Push3AX/USBKeylogger/images/case.jpg

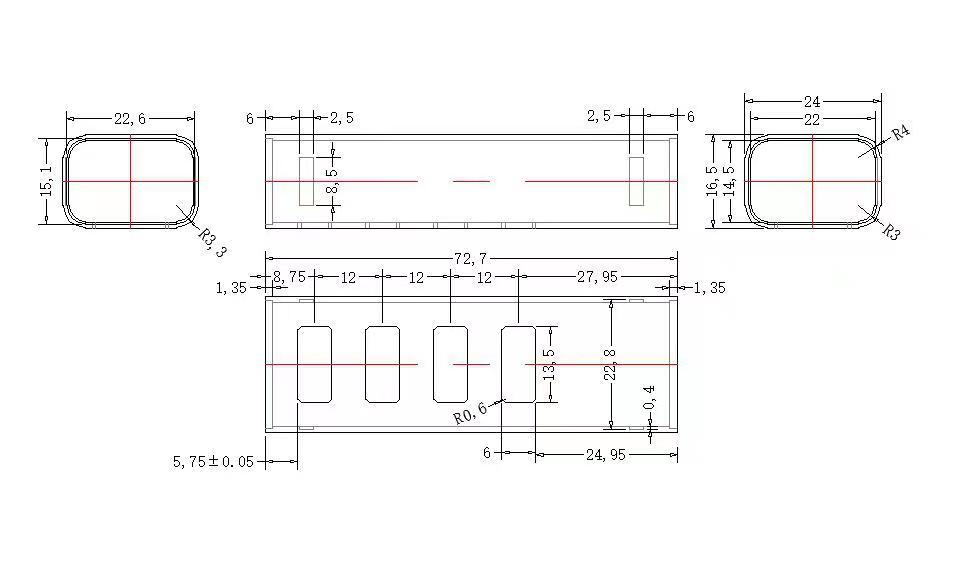
images/case.jpg
