Push3AX/USBKeylogger/images/web.jpg

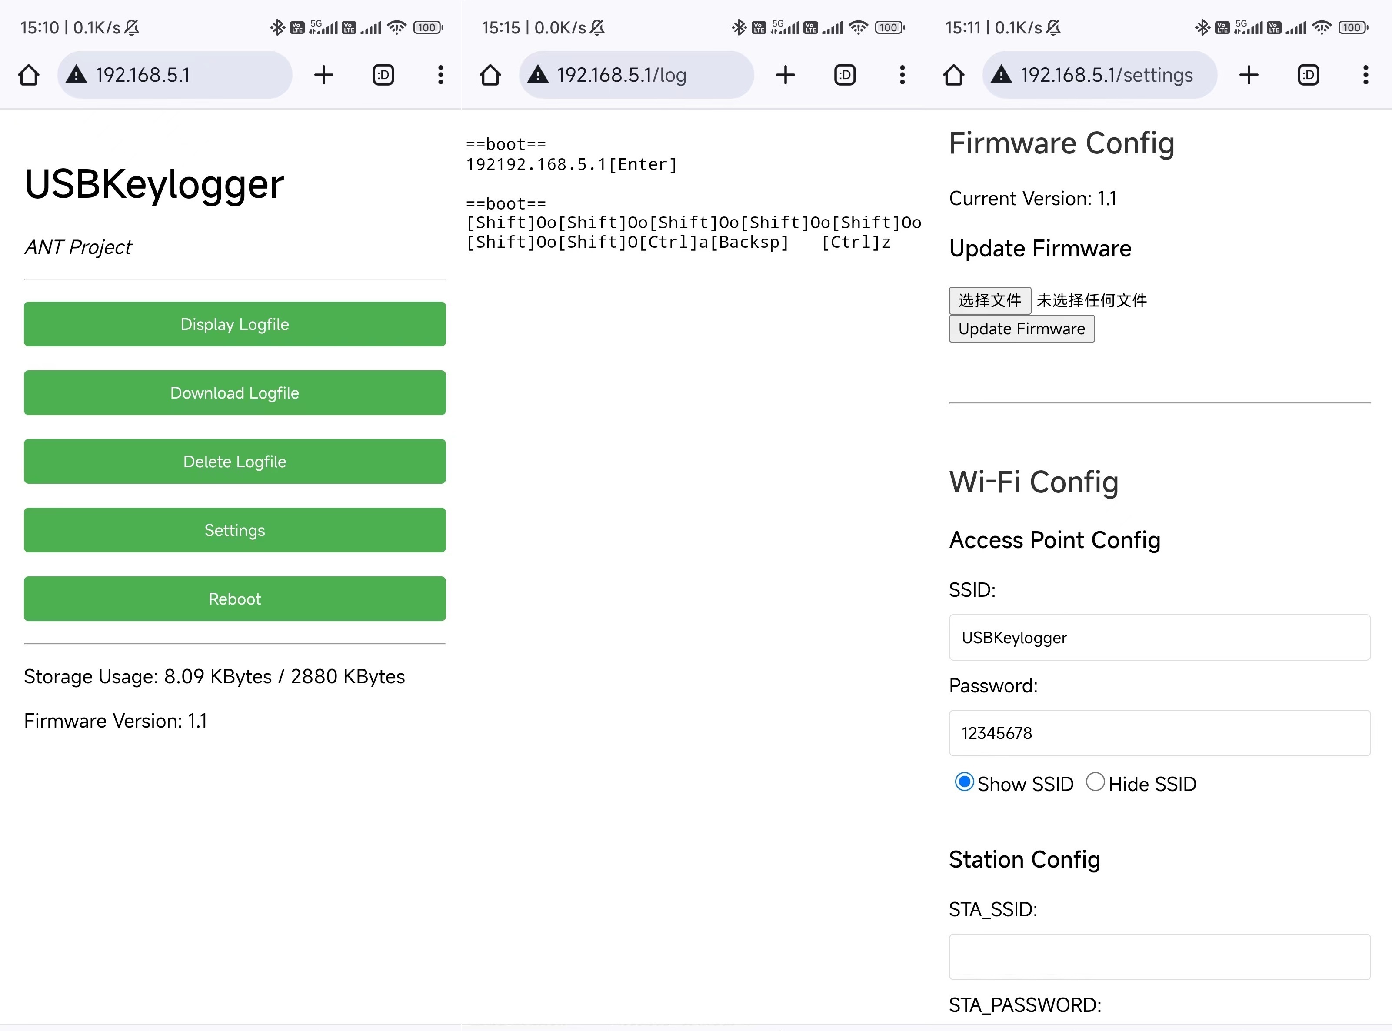
images/web.jpg
