Push3AX/USBKeylogger/Hardware/V2/BOM_USBKeylogger_v2.xlsx

No. | Quantity | Comment | Designator | Footprint | Value | Manufacturer Part | Manufacturer | Supplier Part | Supplier
1 | 8 | 10uF | C1,C3,C5,C9,C10,C11,C13,C15 | C0603 | 10uF | CL10A106MA8NRNC | SAMSUNG(三星) | C96446 | LCSC
2 | 9 | 100nF | C2,C4,C6,C8,C12,C14,C16,C18,C20 | C0603 | 100nF | CC0603KRX7R9BB104 | YAGEO(国巨) | C14663 | LCSC
3 | 3 | 10uF | C7,C17,C19 | CAP-SMD_L3.2-W1.6-RD-C7171 | 10uF | TAJA106K016RNJ | Kyocera AVX | C7171 | LCSC
4 | 1 | ASMD1206-200 | F1 | F1206 |  | ASMD1206-200 | JDTfuse集电通 | C135342 | LCSC
5 | 1 | 2.54-1*4P反弯排针 | H1 | HDR-TH_4P-P2.54-H-M-W10.4 |  | 2.54-1*4P反弯排针 | BOOMELE(博穆精密) | C91552 | LCSC
6 | 1 | ESP-07S | MK1 | WIRELM-SMD_ESP-07S |  | ESP-07S | Ai-Thinker(安信可) | C82895 | LCSC
7 | 1 | SL2.1A | U1 | SOP-16_L10.0-W3.9-P1.27-LS6.0-BL |  | SL2.1A | CoreChips(和芯润德) | C192893 | LCSC
8 | 1 | AMS1117-3.3 | U2 | SOT-223-4_L6.5-W3.5-P2.30-LS7.0-BR |  | AMS1117-3.3 | UMW(友台半导体) | C347222 | LCSC
9 | 2 | CH9350L | U3,U4 | LQFP-48_L7.0-W7.0-P0.50-LS9.0-BL |  | CH9350L | WCH(南京沁恒) | C109472 | LCSC
10 | 4 | 916-351A1024Y10200 | USB1,USB2,USB3,USB4 | USB-A-TH_USB-M-8 |  | 916-351A1024Y10200 | 精拓金 | C39453 | LCSC
11 | 1 | 12MHz | X1 | CRYSTAL-SMD_4P-L2.5-W2.0-BL | 12MHz | TXM12M0004252LBCEO00T | TAE(雅晶鑫) | C284156 | LCSC
