Push3AX/USBKeylogger/Hardware/V2/PCB_USBKeylogger_v2.pdf

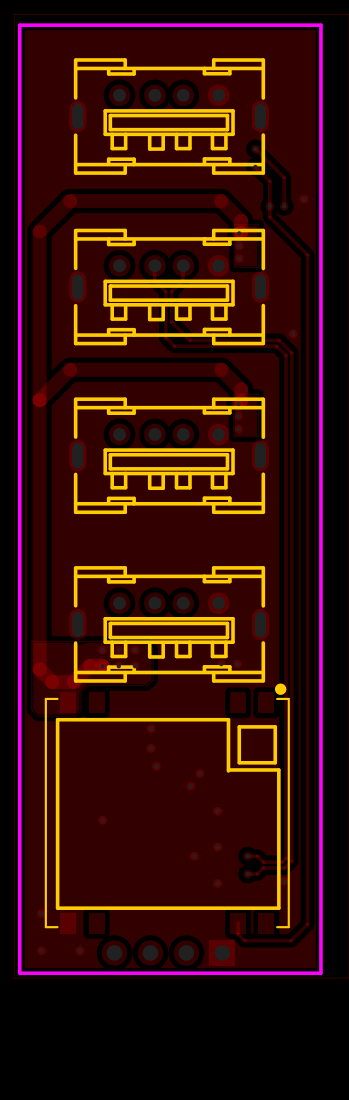
[picture p14: page 1]

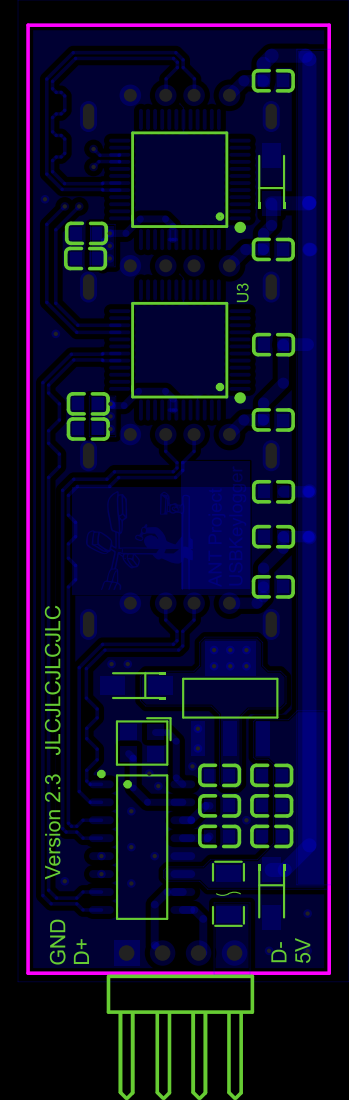
[picture p15: page 2]

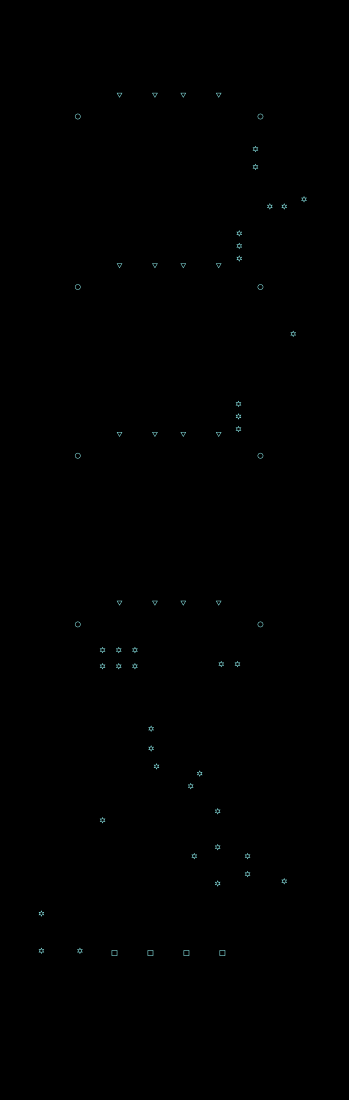
[picture p16: page 3]
