Push3AX/USBKeylogger/USBKeylogger.ino/USBKeylogger/favicon.h

#pragma once

#define PNG_Favicon_Len 818
const uint8_t PNG_Favicon[] PROGMEM = {
  0x89, 0x50, 0x4E, 0x47, 0x0D, 0x0A, 0x1A, 0x0A, 0x00, 0x00, 0x00, 0x0D, 0x49, 0x48, 0x44, 0x52,
  0x00, 0x00, 0x00, 0x10, 0x00, 0x00, 0x00, 0x10, 0x08, 0x06, 0x00, 0x00, 0x00, 0x1F, 0xF3, 0xFF,
  0x61, 0x00, 0x00, 0x00, 0x01, 0x73, 0x52, 0x47, 0x42, 0x00, 0xAE, 0xCE, 0x1C, 0xE9, 0x00, 0x00,
  0x00, 0x04, 0x67, 0x41, 0x4D, 0x41, 0x00, 0x00, 0xB1, 0x8F, 0x0B, 0xFC, 0x61, 0x05, 0x00, 0x00,
  0x00, 0x09, 0x70, 0x48, 0x59, 0x73, 0x00, 0x00, 0x0E, 0xC3, 0x00, 0x00, 0x0E, 0xC3, 0x01, 0xC7,
  0x6F, 0xA8, 0x64, 0x00, 0x00, 0x02, 0xC7, 0x49, 0x44, 0x41, 0x54, 0x38, 0x4F, 0x75, 0x92, 0x5D,
  0x48, 0x93, 0x51, 0x18, 0xC7, 0x77, 0x5F, 0x5D, 0xE8, 0x65, 0x45, 0x49, 0x37, 0x41, 0x64, 0x16,
  0x92, 0x17, 0x39, 0xAD, 0x96, 0x98, 0x64, 0xDF, 0x17, 0xD1, 0x2C, 0x68, 0xEE, 0x43, 0x5D, 0x2A,
  0xBA, 0x34, 0xA2, 0x0C, 0xD2, 0x88, 0x9C, 0x66, 0xD9, 0xA2, 0x32, 0xDB, 0xDC, 0x7C, 0xDD, 0xA6,
  0xE8, 0xDC, 0xA6, 0x42, 0xA6, 0x52, 0x59, 0xF3, 0x6B, 0x73, 0xB3, 0x89, 0x5D, 0xA4, 0x32, 0xC8,
  0xA5, 0x81, 0xE6, 0x8E, 0x38, 0x87, 0xA4, 0xD2, 0xF6, 0xEF, 0x7D, 0x5F, 0xDF, 0x89, 0x8B, 0xFA,
  0xC1, 0xC3, 0xE1, 0x3C, 0xFF, 0x73, 0xFE, 0xE7, 0x79, 0xCE, 0x39, 0xBC, 0x60, 0x28, 0xE4, 0x09,
  0x85, 0x42, 0x84, 0x1E, 0x37, 0x82, 0x99, 0xAF, 0xAC, 0xAE, 0x92, 0x61, 0xA7, 0x8B, 0x34, 0x9B,
  0x5A, 0xC9, 0x94, 0xD7, 0xCB, 0xE6, 0xFE, 0x5E, 0x43, 0x8F, 0x1E, 0xC6, 0x20, 0x80, 0x7F, 0xF0,
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
  0x74, 0x74, 0x34, 0x76, 0xEE, 0xD8, 0x8E, 0x6D, 0x5B, 0xB7, 0xA0, 0xAF, 0xBF, 0x9F, 0xD5, 0x22,
  0x0C, 0x96, 0x97, 0x97, 0xC9, 0x23, 0xFA, 0x99, 0xA4, 0x92, 0x6B, 0xF4, 0x8F, 0x13, 0xC0, 0x6E,
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
};
